cyx13771113683-source/battery-eis-lifetime/report/final_version.md

# 最终版本：2026-10-30 v6

运行目录标识：`battery_ui_run_records_20261030_v6`。`board/application/` 与实板已安装版本逐文件一致；`src/battery_eis/` 是开发源码，测试数据引用改为仓库相对路径。BIT/HWH、校准、模型、采样与保护门限未改变。

- 首页“寿命测量”采集80、17.8、2.16Hz，每点两次，使用本轮完整数据计算SOH。
- 设置页只进行连续单点测量，显示电压、电流及对应频点幅相，不调用寿命模型。
- 寿命测量暂停已有单点；正常完成后恢复原频率和运行状态。原先停止则保持停止；取消或故障停止输出。
- 两张曲线各保留三个频点的最新数据；未更新的点继续显示。显示缓存不参与模型计算。
- 测量记录只显示本次程序启动后获得有效SOH的记录；每次启动列表清空，原始文件保留。
- `runtime.current.log` 每次真实启动重建；系统journal保留。`--verify-only`不清空日志。

## 重启实测

2026-10-30执行一次受控Linux重启。重启前后boot ID不同，服务自动运行v6且处于enabled/active；首帧日志包含`UI_RECORDS_RUN_START count=0`、`UI_FRAME_READY pages=3`。905个原始文件路径及大小与重启前一致，校准和配置SHA-256一致。此项没有启动带载测量；没有执行物理断电冷启动。原始验收JSON和当前启动日志见`data/boot_20261030/`。

板端RTC日期不正确，证据保留原始系统日期；实验日期以客户端2026-10-30为准。
