cyx13771113683-source/battery-eis-lifetime/src/battery_eis/docs/frequency_and_evidence.md

# 频率选择与证据边界

## 选择结果

候选默认 80 Hz，软件允许 10–100 Hz，五点为 10、20、40、80、100 Hz。这是最终 10 Ω/R100/1.249 装配与既有采样实现的待验证区间，尚不是经过实测验证的带宽或准确度指标。最终装配日志采用的 100 Hz/3750 SPS 是数量级计算条件，本程序仍为 80 Hz/30 kS/s 寄存器设置。80 Hz 提高了相对 10 Hz 的周期数，并避开 50/60 Hz 基波；不能据此断言消除了工频污染。100 Hz 与 50 Hz 二次谐波重合，必须用原始数据及外部参考检查。

## 原始文献

1. Yao、Lu、Lei，2021，*Accurate Online Battery Impedance Measurement Method with Low Output Voltage Ripples on Power Converters*，[DOI 10.3390/en14041064](https://www.mdpi.com/1996-1073/14/4/1064)。该实验以开关电阻构造扰动，测试 50–100 Hz 基频并使用奇次谐波获得更高频谱点，采用独立采集与阻抗参考设备。其意义是支持开关负载及高于 10 Hz 的研究方向；采集器、负载及电池状态不同，结果不能直接作为本板验收值。

2. Zhang 等，2020，*Identifying degradation patterns of lithium ion batteries from impedance spectroscopy using machine learning*，[原论文 DOI](https://doi.org/10.1038/s41467-020-15235-7)、[Cambridge 机构库全文](https://api.repository.cam.ac.uk/server/api/core/bitstreams/b9ccb1fc-b812-40d1-aff6-36a5c159e29f/content)。原实验覆盖 0.02 Hz–20 kHz、120 个频率，规定激励及温度/SOC/静置条件，使用跨循环阻抗数据学习退化。本程序的窄频段五点与公开数据的测试域不同，不导入未经本硬件、本电池类型验证的 SOH/RUL 模型。

原文决定可比较的测量条件，器件时序决定本实现可执行的频率范围；论文里的高频上限不能替代本板的抗混叠和低信噪比验证。

## ADS/DAC 时序约束

[ADS1256 数据手册 Rev. K](https://www.ti.com/lit/ds/symlink/ads1256.pdf) 的表 13/14 区分连续转换速率与切换通道后的稳定时间/有效吞吐。30 kS/s 设置下，7.68 MHz 时钟对应约 0.21 ms 稳定时间；理想优化切换吞吐 4374 次/秒是总吞吐。表 4 给出 BUF 关闭、PGA=1、30 kS/s 的典型 10.341 µV RMS 输入噪声。无缓冲的输入负载也必须纳入校准。

本实现串行时钟 1.5625 MHz，每次 MUX 01/23 切换后执行 SYNC、WAKEUP，等待新 DRDY 高→低，再读样本。名义槽长 32768 个 100 MHz 时钟，约 3052 总样本/秒、1526 每通道/秒；共享 SPI 的 DAC 帧会推迟部分槽。RTL 仿真原始记录可见 32769、33330、33379 周期的间隔；每点使用真实 DRDY 时间戳和相位，不假定两通道同时采样。

100 Hz 时每通道约 15 个样本/周期；五次谐波约 500 Hz，尚在该速率的 Nyquist 范围内。ADC 的 DRDY 表示滤波转换就绪，时间戳不是直接测得的采样孔径。两通道复传递校准必须包含这条实际采样链。

[DAC8552 数据手册](https://www.ti.com/lit/ds/symlink/dac8552.pdf) 给出特定负载下典型 10 µs 建立时间；不能用该值代替 IRLZ44N 实际栅极负载的建立时间。DAC 高低电平通过共享 SPI 输出，实际电流的复幅值直接由 R2 测量。DA0 零码确认也不代表已测得栅极电压为零。

## 前端与数量级计算

以下依据 `final_assembly_log_20261021.md` 的最终装配计算，不是实测；制造时期及旧 BE01 的数量级不沿用：

- 电压端名义等效源阻抗 `2.49k || 10k = 1993.595Ω`，10 nF 极点约 7983 Hz；电流差分端 `2×2.49kΩ` 与 10 nF 的极点约 3196 Hz。100 Hz 的名义幅度衰减分别约 0.0078%/0.0489%，两滤波器相位差约 1.0746°（80 Hz 约 0.8598°）。不能仅修改电压还原系数而沿用旧相位校准；实际阻容偏差、ADC 输入负载和寄生还会带来额外误差。
- 两个极点均高于每通道 Nyquist 频率，**并非充分的抗混叠滤波**。方波高次谐波折叠不能由软件拟合保证消除。当前 PS 的 3/5 次谐波、漂移和工频拟合仅用于诊断；须用外部参考、幅度改变及频率邻域复测确认线性和混叠误差。
- 采用日志中的简化假设：R1=10 Ω、R2=0.1 Ω、MOS导通电阻0.035 Ω、电池内阻0.015 Ω，高电平电流约 `Vbat/10.15Ω`：1.5/3.7/5 V 分别为 147.78/364.53/492.61 mA。50%单极方波基波峰值约 `2 I_high/π`。这些是计算值，PS始终使用实测电流。
- 在上述3.7 V工作点，电流基波峰值约0.23207 A，10 mΩ压降经分压后约1.8580 mV峰值。日志更精确地比较内阻15→16 mΩ并计入电流改变：ADC电压阶跃变化291.399 µV、基波峰值185.510 µV、RMS131.176 µV。该计算不等于已实现1 mΩ分辨率。
- 日志中3750 SPS的5.413 µV RMS是数据手册条件值，不能作为本程序30 kS/s或整板实测噪声。若乐观假设独立白噪声，使用30 kS/s典型10.341 µV RMS、每通道1525点，单正交分量标准差为 `σ√(2/N)≈0.375 µV`。这不包含切换相关噪声、漂移、接触、实际ADC滤波、参考误差与校准，也未组合两正交分量及电流通道，**不构成毫欧测量准确度保证**。

## 历史扫频复核

`scripts/verify_history.py` 重新读取三份原始日志，检查 SHA-256、21 个频率×3 轮×4 窗口=252 条记录、63 个完成点、ABI574A、样本计数、完成与中点停机标记。结果在 `reports/historical_evidence.json`。2026-09-25 原始文件没有 `RUN_EXIT=0` 行，报告保留此缺失，不添加伪造标记。

独立重新应用原冻结校准表到 fresh 数据，未重拟合：频点均值最大幅值相对残差 0.047794%，最大相位残差 0.010348°；单窗最大值 0.050957% 和 0.013266°。这些值衡量既有夹具相对电压比的一致性。

旧实验覆盖 100–14900 Hz，使用大信号电阻夹具、单端通道块式采样、旧停机中点。新板则是毫欧级电池纹波、交替差分 MUX 和负载开关。旧结果证明已有数字解调和固定夹具校正可复核，不能证明新板 14.9 kHz 带宽、绝对阻抗精度或电池寿命预测能力。
