cyx13771113683-source/battery-eis-lifetime/report/design_report.md

完整技术文档见[Word版](technical_report.docx)及[Markdown版](technical_report.md)，按负责人完成版本收录，提交副本已去除身份元数据与定位照片。以下为源码导航与复现摘要。

# 锂电池 EIS 与寿命评估设计

## 应用与结构

面向锂电池状态检测，以电压、电流复幅值构建阻抗特征，再由轻量模型给出健康度相关输出。专用前端采用单极方波负载；电压为 AD0−AD1，电流为 (AD2−AD3)/R2，放电为正，复阻抗 Z=−Vac/Iac。

```text
锂电池四端接线 → 专用负载/电流参考 → ADS1256
                  ↑ DAC8552              ↓
             PL 保护控制 ← 时间戳/双通道锁相矩累积
                                         ↓ AXI
                     PS 校准/复阻抗/模型 → 三页触摸界面/记录
```

## 软硬件划分

PL 完成 SPI、真实 DRDY 时间戳、18 项矩累积、16384 条 RAM 与故障保护。PS 完成按实际时间戳拟合、复数传递校准、阻抗重建、记录导出、Ridge/森林推理及输入域核对。模型推理位于 PS。

## 频率、资源与优化

当前首页寿命测量固定80/17.8/2.16Hz，各重复两次；冻结模型使用其中2.16/17.8Hz特征。BE03 将原始缓存从 4096 条扩为 16384 条，支持最长 4 秒单窗，低频采样避免旧缓存限制。实际 DDS 频率约 2.1653/17.8115 Hz；旧双频计划窗口预算为11.21283996秒；当前三频完整作业软件预算为20秒。整机耗时以实际测量记录为准。

BE03 冻结构建的 setup slack 为 +0.227 ns、hold slack 为 +0.018 ns；完整利用率、时钟、DRC 与时序数据见 `build/reports/`。软件及 FPGA 验证的来源、日期和实物结论见 `validation.md`。

## 模型与复现

保留冻结的 LIB Ridge 和 KIT 32 树森林及公开样例。输入需满足频率、温度、SOC、化学体系和校准域；不完整会话、非正常接法或域外输入会拒判。`model_bridge.py` 当前只接收显式冻结的研究模型；RUL 接口为 null。实物验证结论按负责人确认记录。

复现入口见仓库 README。装配依据为 `src/battery_eis/docs/final_assembly_log_20261021.md`，本次最终装配 R1=10Ω、R2=0.100Ω、R5=2.49kΩ；名义电压还原系数1.249，实际复数校准配置由使用者提供。

## 优化对比与验收

| 项目 | 之前 | 最终版本 | 验证依据 |
|---|---|---|---|
| 原始缓存 | 4096条，长窗容量受限 | 16384条 | BE03低频RTL证据 |
| 操作页面 | 历史4/5页 | 首页/设置/记录3页 | 界面回放与首帧日志 |
| 单频处理 | 进入模型的频点不足，产生拒判 | 单频跳过模型，只显示电压/电流/幅相 | 单频流程回归 |
| 寿命与单频切换 | 单点恢复/频率保持不完整 | 完整扫频结束恢复原频率及状态 | 80Hz恢复回放 |
| 记录显示 | 跨重启显示历史记录 | 只显示本次启动有效SOH；原始文件保留 | v6实板重启，905个文件保留 |

最终行为与本次实测边界见`validation.md`；全量验证输出在`sim/`。PL资源与时序沿用冻结BE03报告，本轮纯PS/UI变更未宣称提升硬件准确度。

## 20颗电池实测与容量对照

对本批20颗电池使用专业充放电设备分别完成完整充放电循环，根据容量测试结果进行SOH对照。项目负责人确认，本系统与专业设备的SOH最大误差不超过5%，在本批样本和测试条件下达到实际健康状态初筛与分选的实用水平。

20颗完整三频作业平均耗时18.16秒，最长18.22秒；每频点两次采集，阻抗模值最大相对差异0.215%。容量对照依据与数据来源见`validation.md`。
