cyx13771113683-source/battery-eis-lifetime/report/collaboration.md

# 大模型协作记录

以下为与本提交相关的提示词摘录和实现结果，不含账号或凭据。

| 用户提示词/现场反馈 | AI处理与校验 |
|---|---|
| “就重点在程序解决电流问题” | 区分静态零偏与真实放电，增加有界去零、噪声/漂移检查；没有用清零掩盖过流保护。直流扣除不能代替交流幅相校准。 |
| “单点测量就不要测量寿命了……测完寿命测量恢复80hz” | 单频作业跳过模型；保存并恢复原频率及运行状态；正常完成与取消/故障分支分别回放。 |
| “没测出soh的不要在最后一页记录” | 只筛选显示有效SOH，保留原始会话文件；测试覆盖分页和筛选后序号。 |
| “清空列表，只显示本次启动后的测量；原始文件保留” | 纠正此前只重建运行日志的理解；增加启动前目录快照，不靠错误的板端RTC筛选；真实重启验证列表0条、905个原始文件保留。 |
| “把这个作为最终版本按要求整理最终提交压缩包和github仓库” | 按选拔指南第3.3.5节整理src/sim/build/board/data/skill/report；仅提交电池链路及其必要依赖。 |

## 工作流程与自我纠错

主Agent负责需求、未知根因、板端操作、证据验收与发布。历史独立只读验证覆盖149项主程序测试与7项界面回放；当前v10仓库副本重新通过150项主程序测试、7项界面回放及运行包验证，结果在`sim/`。已发现并纠正界面测试以未筛选历史索引定位行的问题。没有把仿真、公开数据模型回放、实物重启与电池容量准确率混写。

开发过程遵循“现场反馈→定位真实入口和数据来源→最小修改→测试→安装→重启证据”的闭环。复用规则及其触发故障见`skill/README.md`。

2026-11-01批测时，B07和B11首次零激励检查异常。用户重新装夹后两颗均完成；保留失败会话，不放宽10mA检查门限，不用重试成功结果覆盖失败证据。20颗共120次成功频点采集。负责人随后确认已完成20颗独立容量对照，SOH最大误差不超过5%；仓库记录此确认来源，不编造未提供的逐颗参考容量。
