cyx13771113683-source/battery-eis-lifetime/report/technical_report_assets/media/image11.jpeg

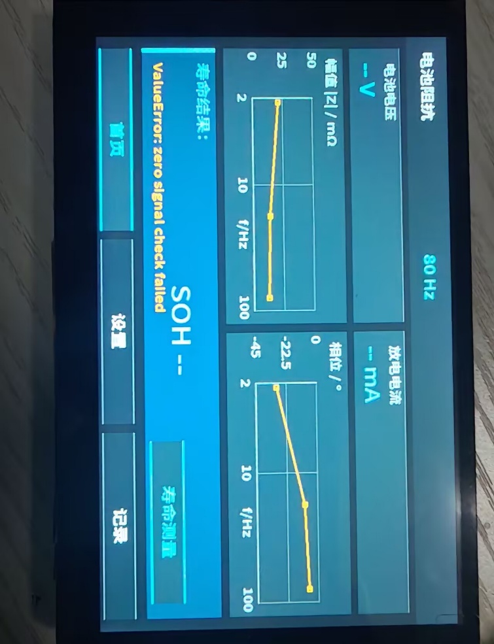
report/technical_report_assets/media/image11.jpeg
