cyx13771113683-source/battery-eis-lifetime/report/technical_report_assets/media/image18.jpeg

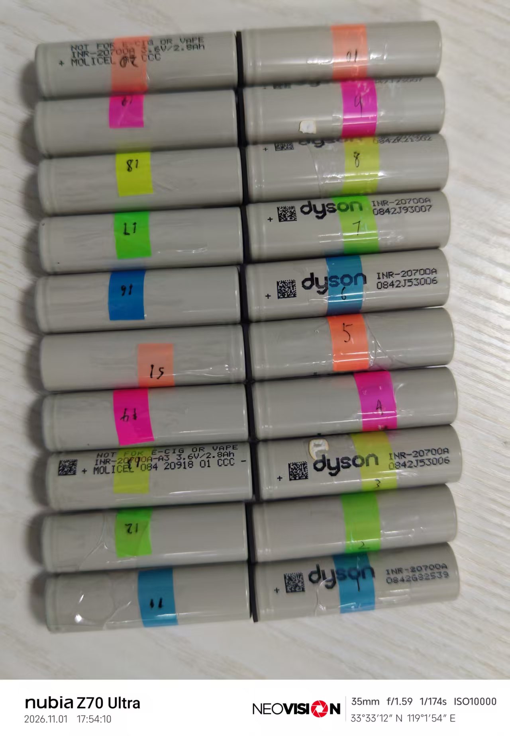
report/technical_report_assets/media/image18.jpeg
