cyx13771113683-source/battery-eis-lifetime/report/validation.md

# 验证说明

## 当前版本

应用为battery_ui_voltage2v_20261031_v10，BE03位流、模型权重和既有校准保持不变。board/application/与实际批测运行文件逐文件一致，src/为匹配源码。v10有效测量范围2.0至4.0 V，最大电流0.4 A；两个模型实部特征下限为0 Ω，其他质量、幅相及故障检查保留。修改软件门限不扩展电芯允许的放电范围，也不扩大模型训练数据范围。

## 20颗实测与容量对照

2026-11-01，B01至B20全部完成三频、每频两次采集。平均完整作业耗时18.16 s，最长18.22 s。80、17.8、2.16 Hz阻抗模值平均重复差异分别为0.090%、0.073%、0.054%，全部60组的最大相对差异0.215%；差异以两次模值之差绝对值除以两次模值平均值计算。该指标是固定装夹下的短时重复性，不是绝对阻抗准确度。B07和B11首次失败已保留，不算入成功窗口的重复性统计。

项目负责人确认：20颗均使用专业充放电设备完成完整充放电循环并进行容量SOH对照，本系统SOH最大误差不超过5%，在本批样本与测试条件下达到健康状态初筛和分选的实用水平。来源记录见data/batch_20/capacity_comparison_confirmation.json；逐颗参考值及误差口径未随文件提供，不声称由仓库脚本独立复算。SOH不等同剩余年限或循环次数，RUL仍为null。

原始数据见data/batch_20/，归档全部22次尝试，含20个成功会话的120次频点采集和两次预检失败。实测结果不由显示缓存或旧数据补齐。

## 软件与历史证据

离线检查入口见README及sim/。v10部署首帧、保护门限和配置不变记录见data/runtime_v10/。2026-10-30的v6 Linux重启验收见data/boot_20261030/：服务自动启动、记录列表清空、905个原始文件保留。这是历史重启证据，不冒充v10冷断电验证。

sim/evidence/与build/reports/保留BE03冻结RTL与综合实现报告。本次同步没有连接板卡、重新综合FPGA或改动实物校准；离线软件验证与既有FPGA报告分别记载。
