cyx13771113683-source/battery-eis-lifetime/data/batch_20/results.csv

电池编号 | 测前电压/V | 80 Hz阻抗模值/mΩ | 17.8 Hz阻抗模值/mΩ | 2.16 Hz阻抗模值/mΩ | SOH估计值/% | 测量状态
B01 | 3.431851 | 13.747789 | 14.962975 | 22.319483 | 77.279823 | 完成
B02 | 3.440638 | 14.288259 | 15.561662 | 23.125347 | 75.977777 | 完成
B03 | 3.600005 | 12.208167 | 13.405513 | 18.823266 | 83.732975 | 完成
B04 | 3.846981 | 12.613675 | 13.732568 | 20.233314 | 76.005307 | 完成
B05 | 3.015782 | 12.888658 | 14.254318 | 21.834652 | 71.945121 | 完成
B06 | 3.618466 | 12.260813 | 13.458024 | 18.845301 | 83.895749 | 完成
B07 | 3.915208 | 12.124454 | 13.147644 | 19.273896 | 77.976936 | 完成
B08 | 3.812389 | 12.958671 | 14.064549 | 20.717148 | 76.385608 | 完成
B09 | 3.894885 | 11.671820 | 12.653690 | 18.817299 | 79.681245 | 完成
B10 | 3.618099 | 12.220436 | 13.427794 | 18.828584 | 83.850517 | 完成
B11 | 3.752117 | 10.050080 | 11.285877 | 12.685579 | 95.183615 | 完成
B12 | 3.525488 | 10.299954 | 11.554767 | 12.519661 | 96.478848 | 完成
B13 | 3.913398 | 10.140051 | 11.251128 | 15.394824 | 88.816492 | 完成
B14 | 3.793425 | 10.067706 | 11.296441 | 13.328175 | 93.368317 | 完成
B15 | 3.915258 | 10.192298 | 11.497844 | 16.258444 | 86.275002 | 完成
B16 | 3.500956 | 10.203329 | 11.465291 | 12.556968 | 96.033594 | 完成
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
