cyx13771113683-source/battery-eis-lifetime/src/battery_eis/ps/panel.py

"""800x600 panel preserving the approved graphite/cyan/blue composition.

The operator UI has exactly three pages: home, settings and records. The
former calibration and status pages are gone; the content they carried that
is still required (calibration state, A/B contact position, measurement
status and failure reasons) now lives on settings and home, so deleting the
pages does not hide any measurement information.

2026-10-27, user decision: the 扫频 page was renamed 设置 and the 校准 and
状态 pages were deleted. Do not restore them from the dated archives under
build/, reports/ui_deploy_20261027/, reports/ui_start_feedback_20261027/ or
deliverables/ui_spectra_records_20261027/ - those are evidence snapshots, not
code to fix. See ../reports/ui_three_pages_20261027/README.md and the
workspace AGENTS.md section "ui-three-pages".

NumPy glyph atlas keeps PIL/font discovery off the embedded runtime path.
"""
from pathlib import Path
import numpy as np
from configuration import DEFAULT_SWEEP
from ui_records import UI_LABELS,health_values,source_label,spectrum_points,number,record_status_label,record_calibration_label

BG=(29,26,24);SURFACE=(48,42,36);DARK=(37,33,29);TEXT=(247,244,241)
MUTED=(204,195,184);CYAN=(232,201,72);BLUE=(255,181,123);AI=(63,43,29)
BORDER=(85,81,77);ORANGE=(88,171,255)
LABELS='电池阻抗首页设置记录电压电流复相位测量进度开始取消已停止准备未接入中自检采集分析完成待核验错误超时正在清理数据保存模型未配置物理接线确认当前温度未知标准件选择单点上一下一重复次正常外置串联先停励后移动仅正极取样线位置返回端保持不动内部不等于整机标定禁止单独接无源电阻先完成再停机记录有效低信号请查看详情仿真已标定未标定外部核验幅值原始信号拒绝无寿命结果重新测量配置文件初始化未就绪传感器'
LABELS+=' 0123456789ABCDEFGHIJKLMNOPQRSTUVWXYZabcdefghijklmnopqrstuvwxyz.,:+-/%()=[]_°Ωμ→：'
LABELS+=UI_LABELS
STATUS={'IDLE':'准备就绪','INITIALIZING':'初始化','PREFLIGHT':'自检中','CAPTURING':'采集中',
        'ANALYZING':'分析中','CANCELLING':'正在停止','DONE':'测量完成','UNVERIFIED':'待核验',
        'ERROR':'测量错误','TIMEOUT':'采集超时','CANCELLED':'已取消'}
BUSY={'INITIALIZING','PREFLIGHT','CAPTURING','ANALYZING','CANCELLING'}
NAV=('首页','设置','记录')
NAV_RECTS=tuple((16+i*260,540,264+i*260,594) for i in range(3))

def ai_label(ai):
    ai=ai or {}
    if ai.get('status')=='prototype_result' and ai.get('soh') is not None:
        return 'SOH健康度 %.1f%%'%(100*ai['soh'])
    if ai.get('status')=='research_estimate' and ai.get('soh') is not None:
        return '研究 SOH %.1f%%'%(100*ai['soh'])
    if ai.get('reason')=='awaiting_measurement':return '模型已载入'
    if ai.get('reason')=='domain_requires_validation':return '目标电池待验证'
    if ai.get('status')=='rejected':return '数据待核验'
    return '模型未配置'

class Painter:
    def __init__(self,atlas=None):
        # NpzFile indexing decompresses each glyph again, including width checks.
        # Decode once before the UI loop; pixels and all layout rules stay exact.
        with np.load(atlas or Path(__file__).resolve().parents[1]/'assets/glyphs.npz',allow_pickle=False) as archive:
            self.atlas={key:archive[key] for key in archive.files}
        self.bounds=[]

    def width(self,text,size):return sum(self.atlas['%d_%d'%(size,ord(c))].shape[1] for c in text)

    def text(self,frame,x,y,text,size=24,color=TEXT,width=750):
        text=str(text)
        # Missing user metadata chars use '?' rather than silently disappearing.
        text=''.join(c if '%d_%d'%(size,ord(c)) in self.atlas else '?' for c in text)
        while text and self.width(text,size)>width:text=text[:-1]
        self.bounds.append((x,y,x+self.width(text,size),y+size+8,text))
        for char in text:
            mask=self.atlas['%d_%d'%(size,ord(char))]
            h,w=mask.shape
            if x<0 or y<0 or x+w>800 or y+h>600:raise ValueError('text outside frame')
            alpha=mask.astype(np.uint16)[...,None]
            region=frame[y:y+h,x:x+w]
            region[:]=(region.astype(np.uint16)*(255-alpha)+np.array(color,dtype=np.uint16)*alpha+127)//255
            x+=w

    def _center_text(self,frame,rect,text,size=20,color=TEXT):
        x,y,x1,y1=rect;text=str(text)
        text=''.join(c if '%d_%d'%(size,ord(c)) in self.atlas else '?' for c in text)
        while text and self.width(text,size)>x1-x:text=text[:-1]
        self.text(frame,x+(x1-x-self.width(text,size))//2,y+(y1-y-size-8)//2,
                  text,size,color,width=x1-x)

    def button(self,frame,rect,label,active=False):
        x,y,x1,y1=rect;frame[y:y1,x:x1]=SURFACE if active else DARK
        frame[y:y+2,x:x1]=CYAN if active else BORDER;frame[y1-2:y1,x:x1]=CYAN if active else BORDER
        self.text(frame,x+(x1-x-self.width(label,24))//2,y+(y1-y-32)//2,label,color=CYAN if active else TEXT,width=x1-x)

    def render(self,state,page=0,selected_hz=80,sweep=False,position='normal',calibrated=False,frequencies=DEFAULT_SWEEP,history=None,record=None):
        if page not in (0,1,2):raise ValueError('operator UI has exactly three pages')
        live_busy=state.get('status') in BUSY or state.get('single_running') or state.get('lifetime_running')
        if record is not None:
            state=dict(record,viewing_record=True)
            calibrated=record.get('calibrated',False)
        frame=np.empty((600,800,3),dtype=np.uint8);frame[:]=BG;frame[:70]=DARK;self.bounds=[]
        if page==2 and (history or {}).get('selected') is not None:
            frame[:]=BG
            self.history(frame,history)
            return frame
        self.text(frame,20,20,'电池阻抗',24,width=210)
        header_frequency=(history or {}).get('selected') if page==2 else None
        header_frequency=(header_frequency or state).get('frequency_hz',selected_hz)
        self.text(frame,300,22,('%g Hz'%header_frequency),24,CYAN,width=200)
        busy=live_busy
        if busy:self.button(frame,(646,10,784,60),'取消',True)
        for index,label in enumerate(NAV):self.button(frame,NAV_RECTS[index],label,index==page)
        result=state.get('result')
        def value(key,fmt,factor=1):
            val=result.get(key) if result else None
            return '--' if not number(val) else format(val*factor,fmt)
        if page==0:
            for x,x1,label,val in [(16,392,'电池电压',value('voltage_dc_v','.4f')+' V'),
                                  (404,784,'放电电流',value('current_dc_a','.3f',1000)+' mA')]:
                frame[82:168,x:x1]=SURFACE;frame[82:83,x:x1]=BORDER
                self.text(frame,x+20,87,label,20,MUTED,width=x1-x-40)
                self.text(frame,x+20,119,val,32,CYAN,width=x1-x-40)
            rows=state.get('spectrum') or ([result] if result else [])
            points=spectrum_points(rows)
            self.graph(frame,(16,180,392,384),'幅值 |Z| / mΩ',points,'magnitude_mohm')
            self.graph(frame,(404,180,784,384),'相位 / °',points,'phase_deg')
            frame[398:522,16:784]=AI;frame[398:522,16:21]=BLUE
            health=health_values(state.get('ai'))
            self.text(frame,36,405,'寿命结果：',24,BLUE,width=160)
            self._center_text(frame,(16,398,784,522),health['soh'].replace('SOH健康度 ','SOH '),40,BLUE)
            # The former status page is gone, so home carries status and reason.
            error=state.get('error')
            if error:
                self.text(frame,36,483,error,20,ORANGE,width=490)
            elif busy:
                label=STATUS.get(state.get('status','IDLE'),'待核验')
                label+=' %d/%d'%(state.get('completed',0),state.get('total',0))
                self.text(frame,36,483,label,20,width=490)
            if record is not None:self.button(frame,(548,458,764,514),'返回实时',True)
            elif state.get('live_controls') and not state.get('lifetime_running'):
                self.button(frame,(548,458,764,514),'寿命测量',True)
            elif not busy:self.button(frame,(548,458,764,514),'开始测量',True)
            else:
                self.text(frame,548,470,'%d%%'%round(100*state.get('progress',0)),24,CYAN,width=210)
        elif page==1:
            self.text(frame,20,84,'设置',24)
            frame[120:248,16:784]=SURFACE
            self.text(frame,36,130,'单点频率',20,MUTED,width=350)
            self.text(frame,36,166,'%g Hz'%selected_hz,32,CYAN,width=350)
            self.button(frame,(420,142,578,202),'上一点');self.button(frame,(600,142,764,202),'下一点')
            self.text(frame,36,212,' / '.join('%g'%f for f in frequencies)+' Hz',20,MUTED,width=720)
            if state.get('live_controls'):
                label='单点暂停' if state.get('single_paused') else '寿命测量中' if state.get('lifetime_running') else '停止单点' if state.get('single_running') else '开始单点'
                self.button(frame,(16,284,784,368),label,state.get('single_running',False))
                self.notice(frame,state.get('ui_notice'))
                return frame
            self.text(frame,36,258,'测量模式',20,MUTED,width=350)
            self.button(frame,(16,284,392,336),'单点',not sweep)
            self.button(frame,(404,284,784,336),'扫频',sweep)
            if not state.get('prototype_mode'):
                self.text(frame,36,346,'接法位置',20,MUTED,width=350)
                for rect,key,label in [((16,372,260,424),'normal','正常'),((278,372,522,424),'A','位置 A'),((540,372,784,424),'B','位置 B')]:
                    self.button(frame,rect,label,position==key)
            self.button(frame,(540,438,764,490),'开始测量',True)
        else:
            self.history(frame,history or {})
        notice=state.get('ui_notice')
        if notice and record is None:
            self.notice(frame,notice)
        return frame

    def notice(self,frame,notice):
        if notice:
            frame[:]=frame//2
            frame[176:430,80:720]=DARK
            frame[176:179,80:720]=ORANGE
            self.text(frame,112,190,notice['title'],24,ORANGE,width=576)
            self.text(frame,112,236,notice['reason'],24,TEXT,width=576)
            self.text(frame,112,286,notice['detail'],20,MUTED,width=576)
            self.text(frame,112,318,notice.get('error',''),20,MUTED,width=576)
            self.button(frame,(280,354,520,406),'知道了',True)

    def line(self,frame,x0,y0,x1,y1,color,width=1):
        count=max(abs(int(x1)-int(x0)),abs(int(y1)-int(y0)))+1
        xs=np.rint(np.linspace(x0,x1,count)).astype(int)
        ys=np.rint(np.linspace(y0,y1,count)).astype(int)
        for dy in range(width):
            valid=(xs>=0)&(xs<800)&(ys+dy>=0)&(ys+dy<600)
            frame[ys[valid]+dy,xs[valid]]=color

    def graph(self,frame,rect,title,points,key):
        x0,y0,x1,y1=rect;frame[y0:y1,x0:x1]=SURFACE
        self.text(frame,x0+14,y0+8,title,20,MUTED,width=280)
        left,right,top,bottom=x0+68,x1-18,y0+53,y1-49
        frequencies=[p['frequency_hz'] for p in points]
        xmin=min([2.]+frequencies);xmax=max([100.]+frequencies)
        if key=='magnitude_mohm':
            high=max([1.]+[p[key]*1.12 for p in points]);power=10**np.floor(np.log10(high))
            high=next(v*power for v in (1,2,5,10) if v*power>=high);low=0.
        else:
            values=[p[key] for p in points]
            low=min(-15.,15*np.floor((min(values)-5)/15)) if values else -90.
            high=max(0.,15*np.ceil((max(values)+5)/15)) if values else 0.
        for value in (high,(high+low)/2,low):
            y=top+(high-value)/(high-low)*(bottom-top)
            self.line(frame,left,y,right,y,BORDER)
            self.text(frame,x0+5,int(y)-12,'%g'%value,20,MUTED,width=60)
        def px(f):return left+np.log(f/xmin)/np.log(xmax/xmin)*(right-left)
        ticks=sorted(set([xmin,xmax]+[f for f in (2.,10.,100.) if xmin<f<xmax]))
        for f in ticks:
            x=px(f);self.line(frame,x,top,x,bottom,BORDER)
            label='%g'%f;w=self.width(label,20)
            self.text(frame,int(max(x0+6,min(x-w/2,x1-w-6))),bottom+6,label,20,MUTED,width=70)
        self.line(frame,left,top,left,bottom,MUTED);self.line(frame,left,bottom,right,bottom,MUTED)
        self.text(frame,x0+235,bottom+6,'f/Hz',20,MUTED,width=72)
        previous=None
        for point in points:
            x=px(point['frequency_hz']);y=top+(high-point[key])/(high-low)*(bottom-top)
            color=CYAN if point['valid'] else ORANGE
            if previous and point['quality_ok'] and previous[2]['quality_ok']:
                if key!='phase_deg' or abs(point[key]-previous[2][key])<=180:
                    self.line(frame,previous[0],previous[1],x,y,color,2)
            if point['quality_ok']:
                self.line(frame,x-3,y-3,x+3,y-3,color,2);self.line(frame,x-3,y+3,x+3,y+3,color,2)
                self.line(frame,x-3,y-3,x-3,y+3,color);self.line(frame,x+3,y-3,x+3,y+3,color)
            else:
                self.line(frame,x-4,y-4,x+4,y+4,ORANGE,2);self.line(frame,x-4,y+4,x+4,y-4,ORANGE,2)
            previous=(x,y,point)
        if not points:self.text(frame,left+28,top+35,'等待测量',20,MUTED,width=200)

    def history(self,frame,history):
        selected=history.get('selected')
        if selected is not None:
            health=health_values(selected.get('ai'))
            soh=health['soh'].replace('SOH健康度 ','SOH：').replace('SOH ','SOH：')
            self.button(frame,(16,16,144,68),'返回')
            self._center_text(frame,(160,16,784,84),soh,40,BLUE)
            points=spectrum_points(selected.get('spectrum') or ([selected['result']] if selected.get('result') else []))
            self.graph(frame,(16,116,392,552),'幅值 |Z| / mΩ',points,'magnitude_mohm')
            self.graph(frame,(404,116,784,552),'相位 / °',points,'phase_deg')
            return
        self.text(frame,20,85,'测量记录',24,width=350)
        self.text(frame,524,87,'共 %d 条'%history.get('count',0),20,MUTED,width=250)
        for column,label in enumerate(('序号','幅值 mΩ','SOH')):
            self._center_text(frame,(16+256*column,114,272+256*column,146),label,20,MUTED)
        for index,row in enumerate(history.get('rows',[])[:4]):
            y=150+index*72;frame[y:y+64,16:784]=SURFACE
            value=(row.get('result') or {}).get('magnitude_ohm')
            self._center_text(frame,(16,y,272,y+64),str(history.get('page',0)*4+index+1))
            self._center_text(frame,(272,y,528,y+64),'%.3f'%(value*1000) if number(value) else '--')
            soh=health_values(row.get('ai'))['soh']
            if row.get('prototype_mode') and soh.startswith('SOH健康度 '):soh=soh[len('SOH健康度 '):]
            self._center_text(frame,(528,y,784,y+64),soh,20,BLUE)
            self._center_text(frame,(708,y,776,y+64),'详情',20,MUTED)
        if not history.get('rows'):self.text(frame,280,260,'暂无测量记录',24,MUTED,width=350)
        self.button(frame,(16,466,194,518),'上一页')
        self.text(frame,300,476,'%d / %d 页'%(history.get('page',0)+1,history.get('pages',1)),24,width=245)
        self.button(frame,(606,466,784,518),'下一页')

def action(point,page,busy,record_detail=False,viewing_record=False,notice=False,live_controls=False,lifetime_running=False):
    x,y=point
    if page==2 and record_detail:
        return ('record_back',None) if 16<=x<144 and 16<=y<68 else None
    if notice:return ('dismiss_notice',None) if 280<=x<520 and 354<=y<406 else None
    for index,(x0,y0,x1,y1) in enumerate(NAV_RECTS):
        if x0<=x<x1 and y0<=y<y1:return ('page',index)
    if 646<=x<784 and 10<=y<60 and busy:return ('cancel',None)
    if page==2:
        if 16<=x<194 and 466<=y<518:return ('record_page',-1)
        if 606<=x<784 and 466<=y<518:return ('record_page',1)
        if 16<=x<784 and 150<=y<430 and (y-150)%72<64:return ('record_open',(y-150)//72)
        return None
    if page==0 and viewing_record:
        return ('return_live',None) if 548<=x<764 and 458<=y<514 else None
    if live_controls:
        if page==0 and not lifetime_running and 536<=x<776 and 446<=y<526:return ('lifetime',None)
        if page==1 and not lifetime_running:
            if 16<=x<784 and 272<=y<380:return ('toggle_single',None)
            if 408<=x<590 and 130<=y<214:return ('frequency',-1)
            if 590<=x<776 and 130<=y<214:return ('frequency',1)
        return None
    if busy:return ('cancel',None) if 646<=x<784 and 10<=y<60 else None
    if page==0 and 548<=x<764 and 458<=y<514:return ('start',None)
    if page==1:
        if 540<=x<764 and 438<=y<490:return ('start',None)
        if 420<=x<578 and 142<=y<202:return ('frequency',-1)
        if 600<=x<764 and 142<=y<202:return ('frequency',1)
        if 284<=y<336:return ('sweep',x>=404)
        if 372<=y<424:return ('position','normal' if x<260 else 'A' if x<522 else 'B')
    return None
