cyx13771113683-source/battery-eis-lifetime/(commit log)

2026-10-29 Prepare battery EIS lifetime competition submission
2026-10-29 Update battery measurement controls and SOH history
2026-10-30 Finalize v6 battery measurement and reboot record reset
2026-11-02 Remove submission author metadata and geotagged sample photograph
